WebMaka/ParametricRackCageGenerator/(threads)

Thread 2 (2025-08-19):

[Feature] Add option for threaded inserts.

woolmonkey, 2025-08-19:
I think it would be a great feature to have the option to add threaded inserts in one side.

WebMaka, 2025-08-29:
New version uploaded with the ability to select threaded inserts for bolt-together ears by their screw size and hole diameter. Includes options for M3-M6 and 4-40-1/4-20 screw sizes in the most common hole diameters. Also automatically thickens the ears from 4-6mm to 6-8mm to accommodate the inserts.

Closed 2025-09-04.
