WebMaka/ParametricRackCageGenerator/(commit log)

2025-08-11 Add files via upload
    * Added version number & notes.
    * Fixed a bug with the cage separating from the faceplate when the clearance setting exceeded 2.5mm.
    [parametric_rack_cage_generator.scad]
2025-08-29 Update parametric_rack_cage_generator.scad
    0.11 - 29 Aug 2025
    - Added support for heat-set threaded inserts on faceplate ears for half- and third-width cages for 19" racks. (Requested by Github user "woolmonkey".)
    [parametric_rack_cage_generator.scad]
2025-08-30 Updated to version 0.12
    0.12 - 30 Aug 2025
    - Added support for half-height cages as well as half-width for 10" racks. (Requested by Github user "FlyingT".)
    [parametric_rack_cage_generator.scad]
